lawabb/rad-gate/doc/rad-gate_schem2.pdf

### Battery Monitor

Test 1-2 | Go Button

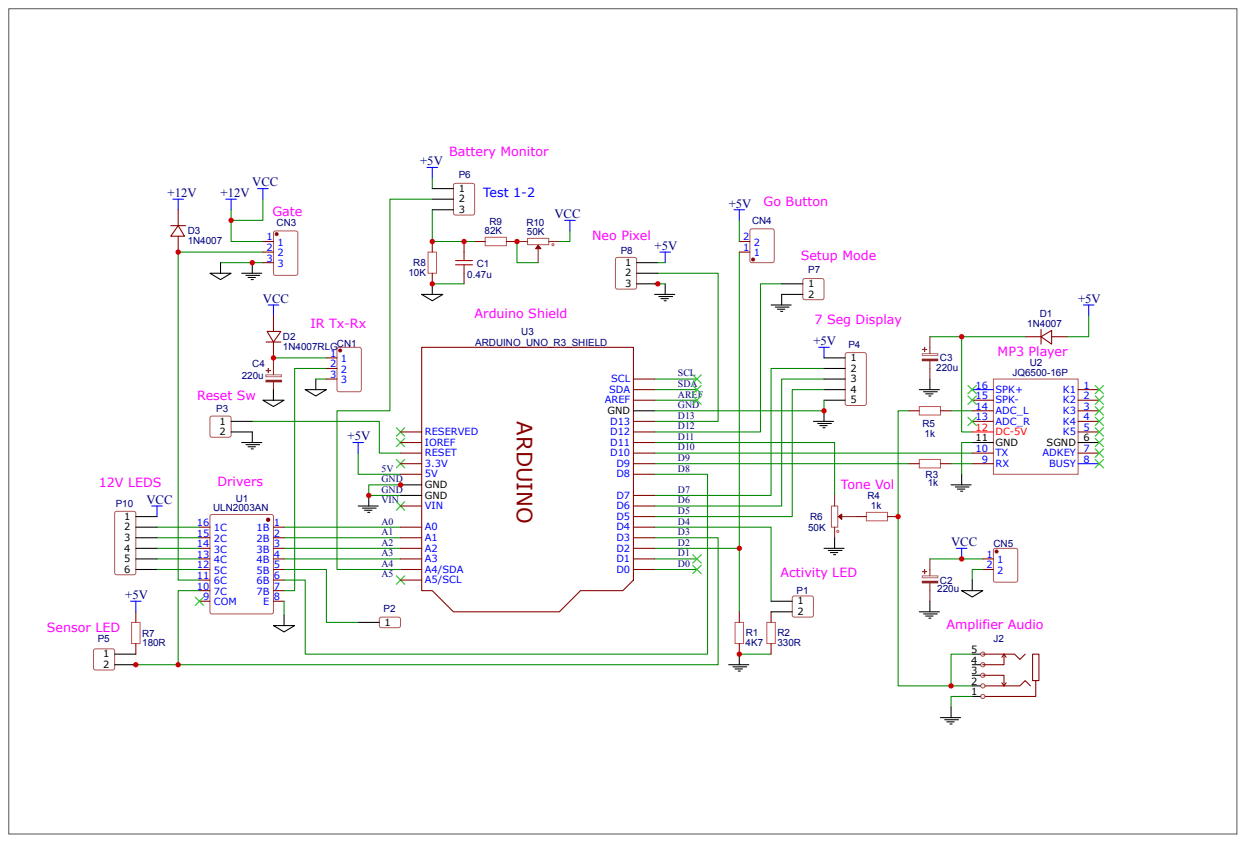
[picture p2: page 1]
