lawabb/rad-gate/doc/rad-gate gate_drive_schem.pdf

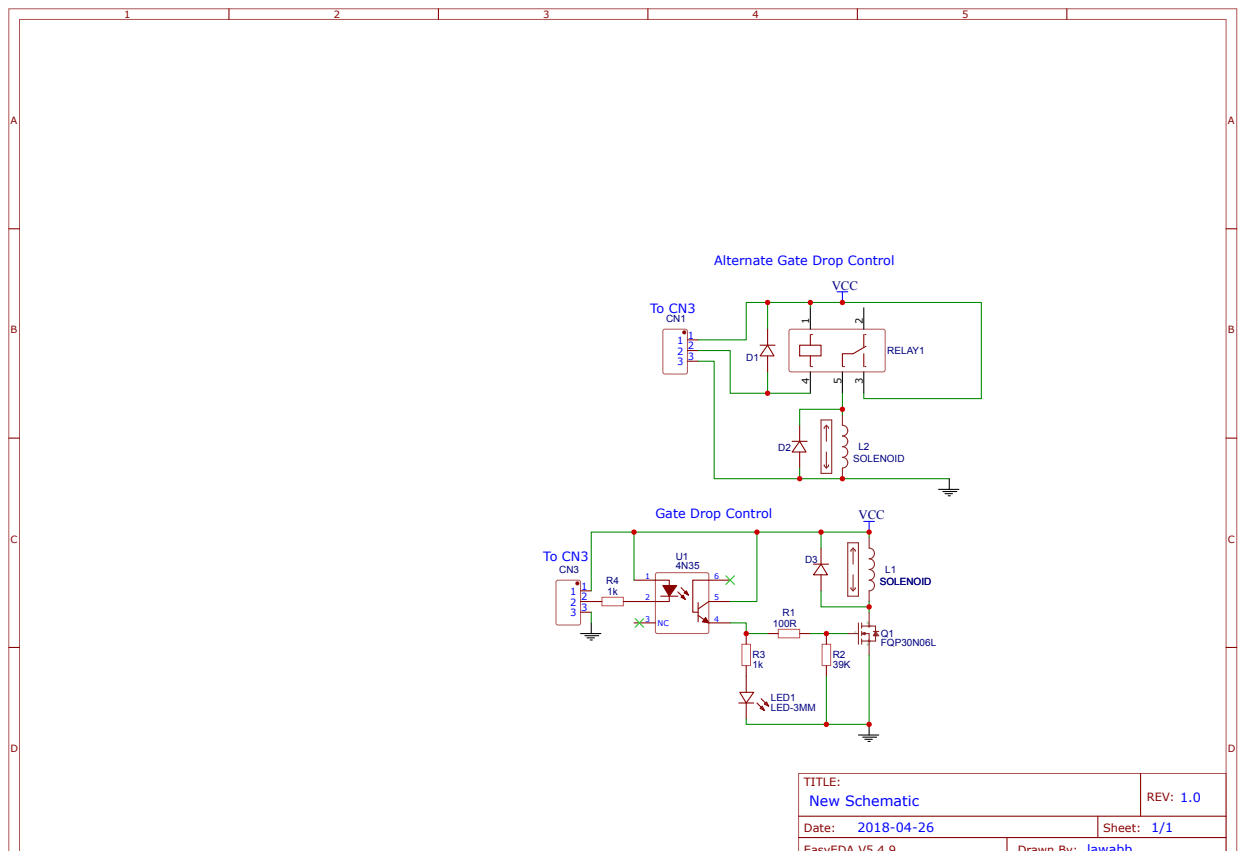
[picture p3: page 1]

Alternate Gate Drop Control

wabb
