lawabb/rad-gate/constants.cpp

/*****************************************
 *  RemoteArDuino (RAD) Gate
 *  (c) Danny Frencham 2017
 *****************************************/

#include <stdint.h>

// variables
uint32_t GATE_DROP_START = 0;
bool FLAG_GATE_DOWN = false;
