lawabb/rad-gate/(commit log)

2018-04-11 Changes from lawabb . Seven segment display is untested on hardware. Battery monitor in progress
2018-04-14 Battery monitor changes
2018-04-26 Minor addition for Adafriut Sound -untested on hardware, current schem
2018-05-03 Change interrupt1 to rising
2018-08-05 Updated schematic
